andreiiulianluca/MediKit/README.md

# MediKit
Portable medical kit made with Arduino

## Developer:
* [Luca Andrei Iulian](https://github.com/andreiiulianluca)

## Purpose
This project has it's mission to solve a real life problem in the medical field. Lets say we have a person under medical observation, neither a nurse or a relative it's available to keep an eye on the patient so we need a portable device easy to use that will notify us in case of any emergency.

## For more technical details please check my PDF documentation
## Check out the demo presentation video
MediKit Demo (https://www.youtube.com/watch?v=KongUmdiwF8)
