andreiiulianluca/MediKit/MediKit.pdf

# Portable MediKit

Luca Andrei Iulian 3E3

January 17, 2022

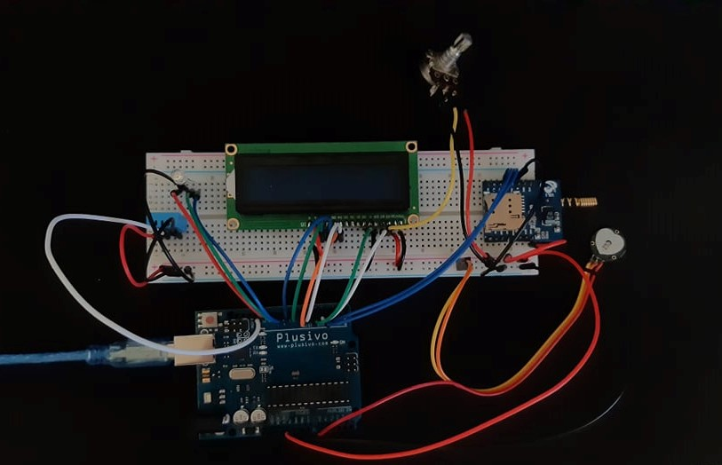
[picture p1: figure]

## 1 Purpose

This project has it’s mission to solve a real life problem in the medical field. Lets say we have a person under medical observation, neither a nurse or a relative it’s available to keep an eye on the patient so we need a portable device easy to use that will notify us in case of any emergency. We can use it in the next situations:

1. In a hospital in a very busy period when no nurse is available for a few patients.
2. At home, when the ill person is under medical observation and a family member have to take care of him and can’t be near his proximity all the time.

Our device is equiped with a:

- 16x2 LED, perfect for debugging or checking up the value returned by the sensors on the spot
- Temperature and Humidity Sensor
- Pulse Sensor
- RGB Led that will show that something it’s wrong lighting the red color also trigering the GSM module that will send an SMS/E-mail
- GSM Module

## 2 Requirements

### 2.1 Parts Required

- 1 Arduino UNO (or any other clone of it)

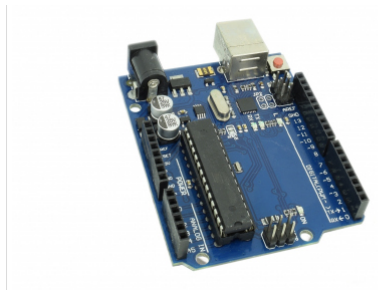
[picture p2: figure]

- 1 Pulse/Oxymeter Sensor
- 1 LCD 16x2

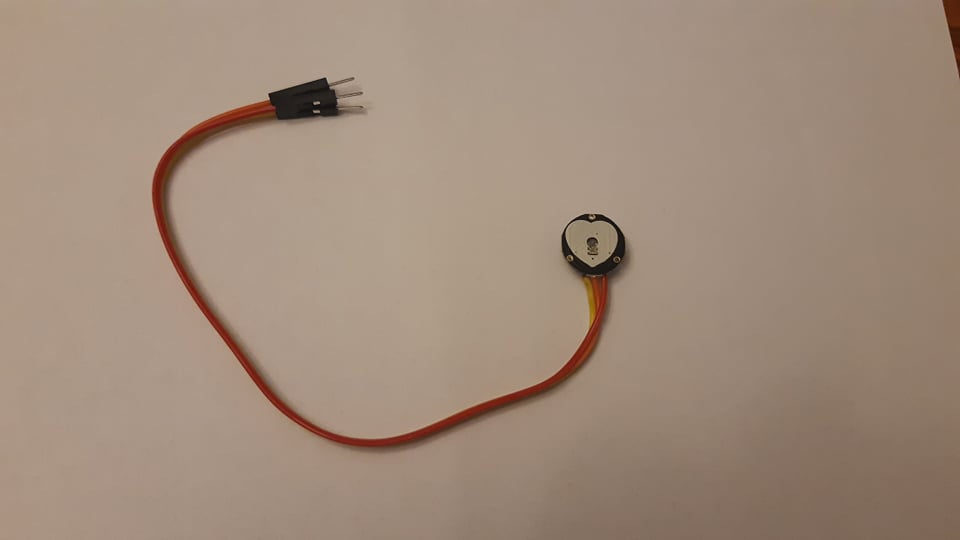
[picture p3: figure]
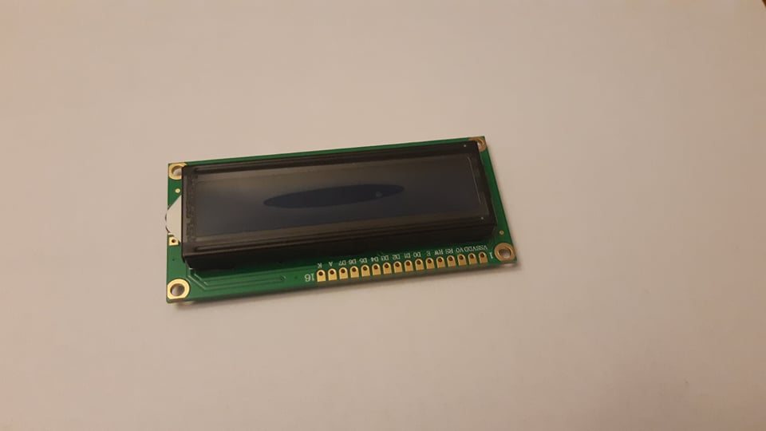
[picture p4: figure]

- 1 GSM and GPRS Module GA6-B

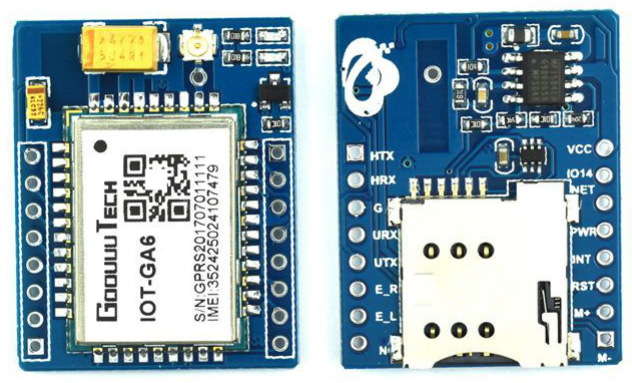
[picture p5: figure]

- 1 RGB Led

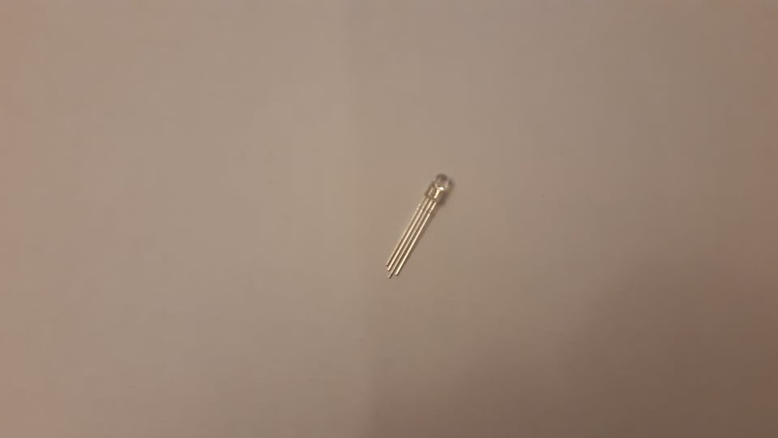
[picture p6: figure]

- 1 DHT11 Temperature and Humidity Sensor

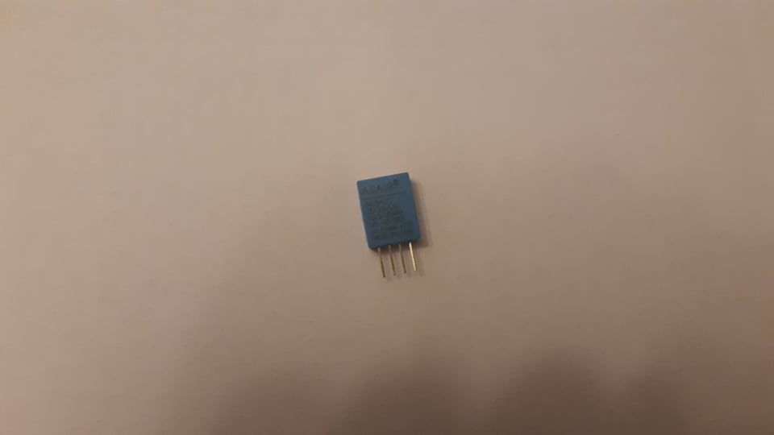
[picture p7: figure]

- 1 Potentiometer (20k Ohm or 10k it’s fine)
- 1 Breadboard
- Hook-Up Wires

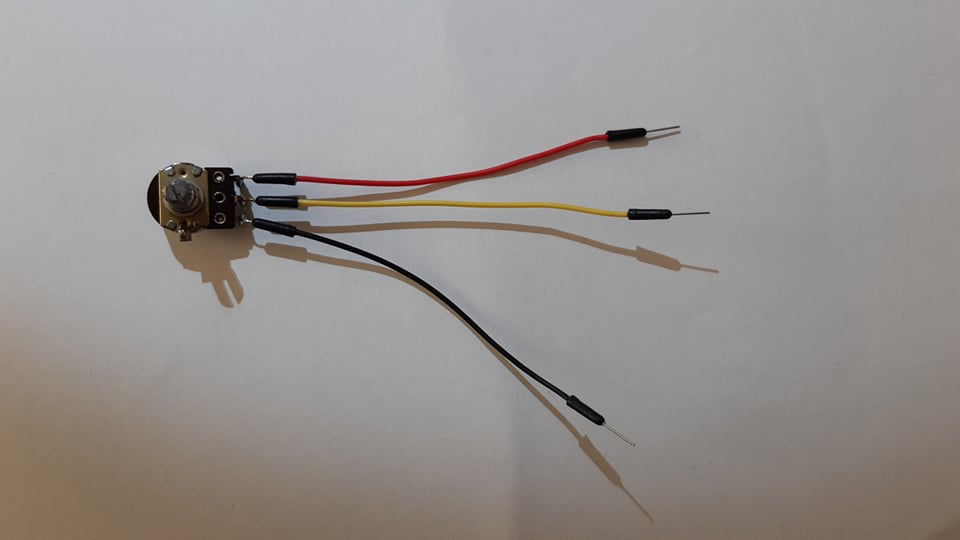
[picture p8: figure]
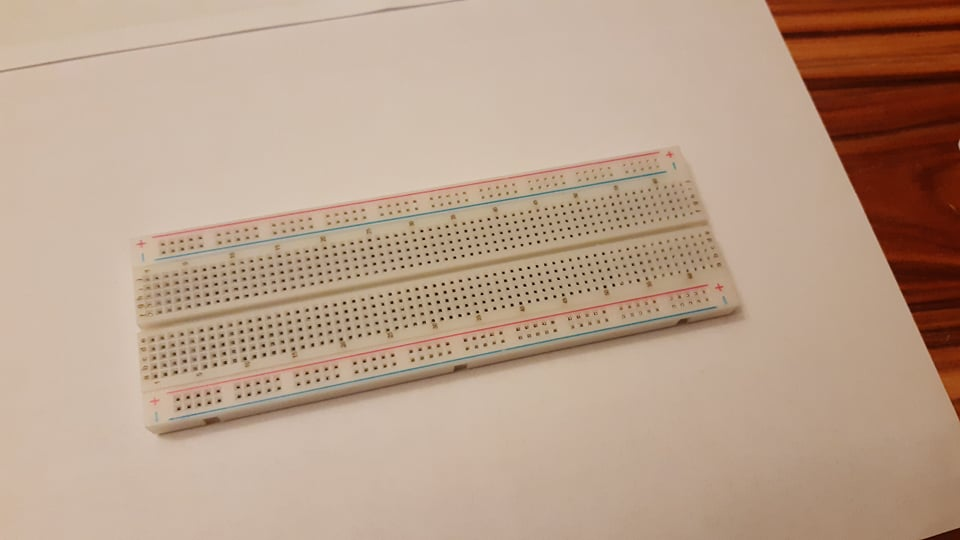
[picture p9: figure]

### 2.2 Costs

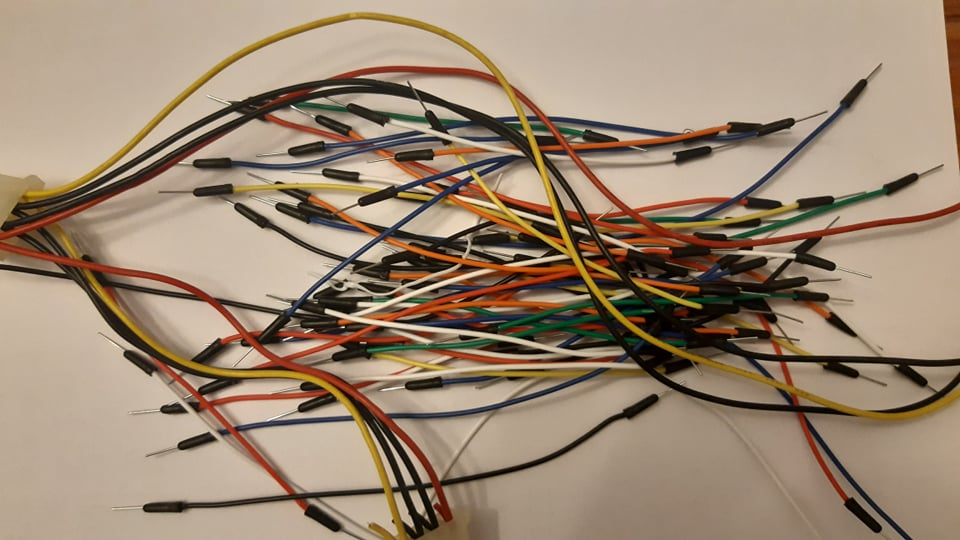
[picture p10: figure]

The total cost of this device including the arduino clone would be around 26 us dollars.

## 3 Brief Description

The patient will have the pulse sensor attached to one of his fingers and will permanently monitor his situation along the ambiental temperature and humidity. With the use of the GSM and GPRS model we will send a notification to the person responsible for the wellbeing of the patient and send the current values received from the sensors. On the LED screen and RGB led attached to breadboard we can monitor on the spot the actual situation.

## 4 The Making of the project and Connections

Firstly, you will have to glue the pins of LED Monitor with your letcon. Then connect:

- Pin 1,16 and 5 are Ground
- Pin 2 and 15 are for 5V Power
- Pin 3 is for the Potentiometer
- Pin 5 goes to pin 5 digital of Arduino
- Pin 11 goes to pin 6 digital of Arduino
- Pin 12 goes to pin 7 digital of Arduino
- Pin 13 goes to pin 9 digital of Arduino
- Pin 14 goes to pin 8 digital of Arduino

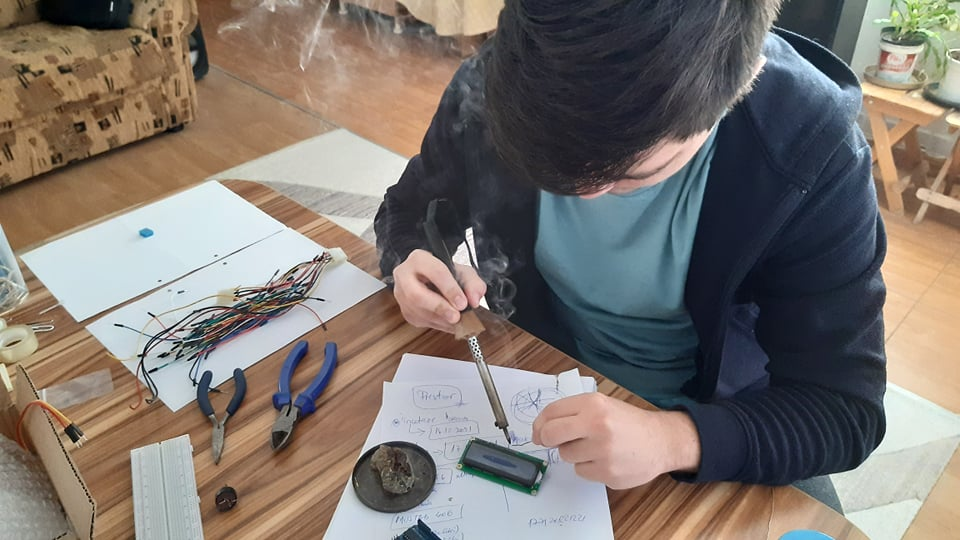
[picture p11: figure]

Then, I added the Potentiometer which is very easy to install and you can controll the contrast of your LCD screen. One pin goes to GND, one to power and the middle one goes to pin 3 of your screen as I also said up.
For the RGB led which will show the overall status of your sensors I used:
- Pin 12 of Arduino for the RED colour
- Pin 11 of Arduino for the GREEN colour
- Pin 10 of Arduino for the BLUE colour

The Temperature and Humidity even if it has 4 pins attached to the breadboard, only 3 of them we will use. One for GND, one for Power and the one closest to the power one we will attach to Pin 13 Digital of the Arduino.
The Pulse sensor also needs one pin to GND, one pin to 5V and the other one to A0 which is the first analog pin of arduino, through this pin we will receive the raw data from the sensor.
Lastly but not least, the GSM module, after you glued all his 14 pins in order to connect it to the breadbaord, this one needs:
- G pin to GND of Arduino
- VCC pin connected to 5V of Arduino
- UNX pin connected to pin 2 of Arduino
- UTX pin connected to pin 3 of Arduino

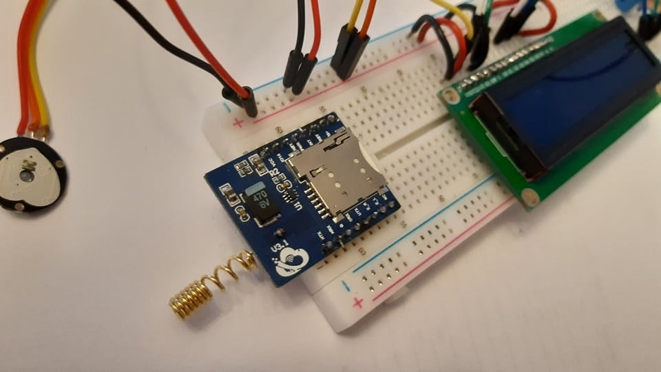
[picture p12: figure]

### 4.1 Personal Tips for Implementation

- Being an analog sensor, the pulse sensor is very sensible.That’s what analog is about, taking weak signal and amplifying it. So, the signal will get disturbed by the GSM module especially when it will send an SMS. You can solve this by protecting the signal wire so that it doesn’t get disturbed so easily, sadly I didn’t have time left to do this but if you try to recreate this project I recommend you doing this.
- When I tried to put every pieces together to work the hard reality hit me, I didn’t have enough amperage, the usb port of laptops only give 500 mA and this wasn’t enough for my lcd screen and gsm module xD. Take a classic usb wire plug it in a phone charger and after splitting the wire put the + wire (red one) in your breadboard so you can charge the high consumers sepparately. From a classic phone charger you will have the same voltage but whith 2A which should be enough and everything will run better.
WARNING Be careful so that your pieces doesn’t receive voltage from both the arduino and the phone charger, this can burn your sensors.
- Keep the connections clean because you will have many devices attached to your arduino and it’s important to see as clear as possible.
- Especially for cheap pulse sensors, where the raw data received from the sensor is not very precise, I’ve tried multiple methods to find the BPM as accurate as possible and this is the best one I’ve found. First plot the raw data and set a treshold based on where you see the spikes when your heart beats, mine is 515. Then you will observe that for every pulse the sensor sents around 10 values above your treshold, so if you increment a value for every pulse the actual value will be 10x bigger than the actual real times your heart beats. Finally, I recommend you to use millis() so you can count how many beats you received in a minute, you can stop when it reached 30 seconds so you can receive the results faster and then simply multiply by 2 your result but preferably let it at 60 seconds for the best accurate results.

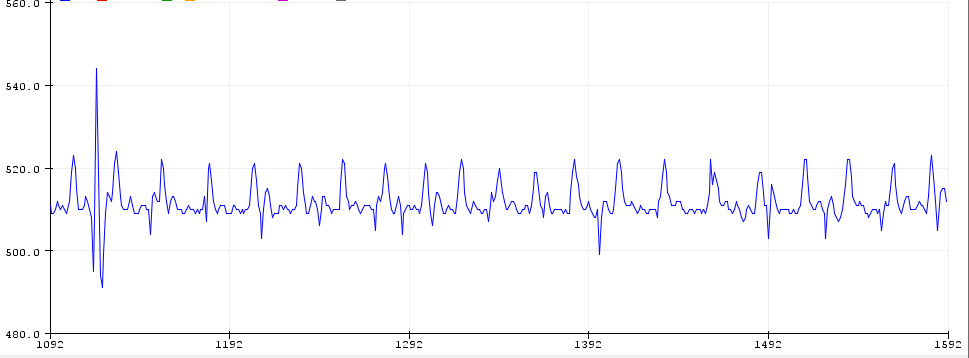
[picture p13: figure]

- For the GSM Module, remove the PIN approval for the SIM card from your phone settings before putting it in the module. I spent about three hours thinking it’s something wrong with my code or the module it’s broken :)

## 5 The Code

#i n cl u d e <S o f t w a r e S e r i a l . h>

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

#i n cl u d e ”DHT. h”

#d e f i n e DHTTYPE DHT11

#d e f i n e DHTPIN 13 //TH s e n s o r

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

}

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

v oid checkUp ( ) {
i f ( calculatedBPM !=0 && ( calculatedBPM < 40 | | calculatedBPM > 1 5 0 ) ){
d i g i t a lW r i t e ( redPin , HIGH ) ;
d i g i t a lW r i t e ( greenPin , LOW) ;
mood = ”Red ” ;
sendSMS ( 1 ) ;
}
i f ( ( calculatedBPM >= 40 && calculatedBPM <= 1 5 0 ) | | calculatedBPM == 0 ){
d i g i t a lW r i t e ( greenPin , HIGH ) ;
d i g i t a lW r i t e ( redPin , LOW) ;
mood = ”Green ” ;
sendSMS ( 0 ) ;
}
i f ( t < 16 | | t > 2 5 ){
mood = ”Red ” ;
sendSMS ( 2 ) ;
}
i f ( h > 50 | | h < 3 0 ){
mood = ”Red ” ;
sendSMS ( 3 ) ;
}
}

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

v oid s e tup ( ) {
S e r i a l . b e gi n ( 9 6 0 0 ) ;
S e r i a l . p r i n t l n (F( ”DHT11 t e s t ! ” ) ) ; sim . b e gi n ( 1 1 5 2 0 0 );
l c d . b e gi n ( 1 6 , 2 ) ;
dht . b e gi n ( ) ;
pinMode ( redPin , OUTPUT) ; pinMode ( greenPin , OUTPUT) ; }

v oid l o o p ( ) {
myTime = m i l l i s ( ) − l a s tO c c u r a n c e ;
readTH = m i l l i s ( ) − THOccurance ;
Si g n al = analogRead ( p ul s ePi n ) ;
h = dht . readHumidity ( ) ; | // re ad humidity
t = dht . readTemperature ( ) ; | // re ad tempe r a tu re
i f ( Si g n al > t h r e s h ol d ){
bpm++;
}
i f (myTime > 3 0 0 0 0 ){ calculatedBPM = bpm/ 1 0 ∗2; showBPM ( ) ;
l a s tO c c u r a n c e += 3 0 0 0 0; bpm = 0 ;
}

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

## 6 The Circuit

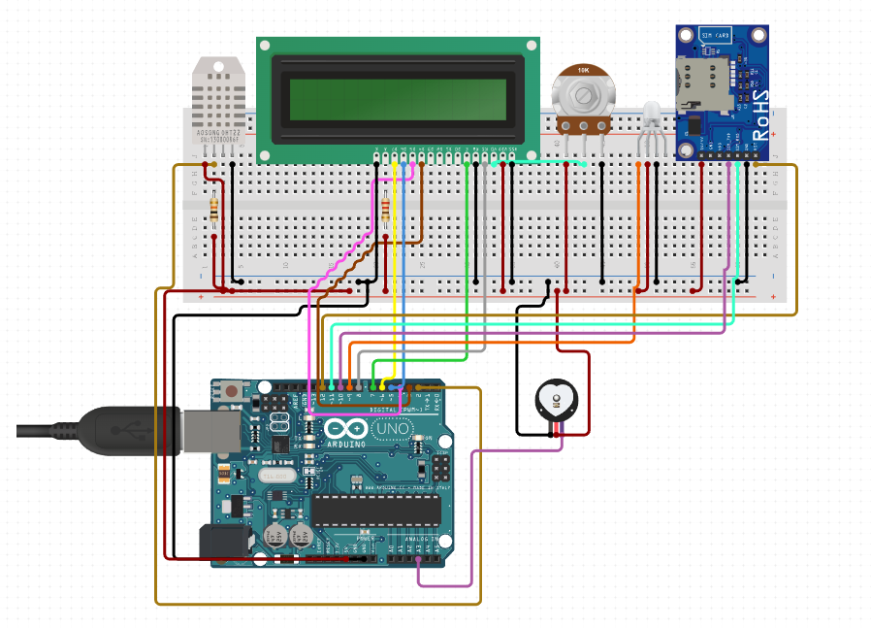
[picture p14: figure]
